terrag42/fastled-arcade/(commit log)

2017-07-09 Make compatible with Arduino Uno, Nano, etc.
    - Removed support for infrared remote to free up some memory. I am using a mode change button that ties a pin to ground when pressed.
    - Added mode indication lights. Since Mode 1 is loaded on startup, the first time the mode button is pressed, it will
    show the lights for mode 2.
    - Removed one of the games (launcher) because it used too much memory in global variables. Perhaps it could be added back with fewer balls.
    - Reversed the logic for lighting arcade buttons in the main sketch and also on the "simon" game. I chose to wire the LEDS
    so that the Arduino would sink current instead of source it.
    - Changed the velocityDecay constant (Juggle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
    [fastled-arcade.ino]
2017-07-09 Change velocityDecay constant for 112 LEDs
2017-07-09 Change logic - Arcade button LED wiring
2017-07-09 Make compatible with Arduino Nano, Uno
